danielpickett/ergogen-keyboard/docs/plates/right-switch-plate.dxf

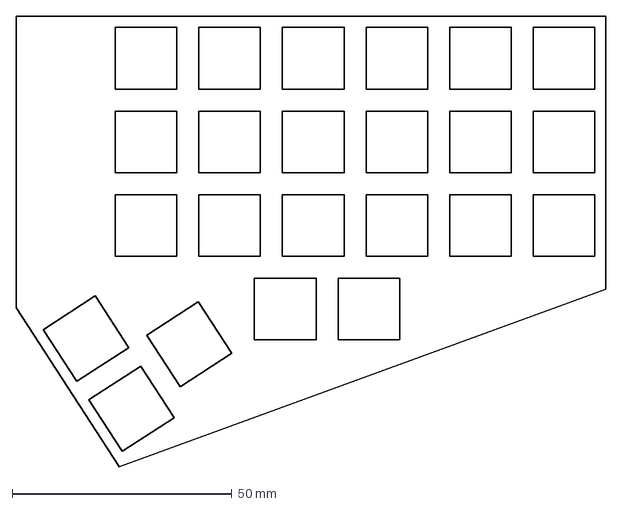
[picture p1: CAD file, 2026-11-01]
docs/plates/right-switch-plate.dxf
134.0 x 102.3 mm
