danielpickett/ergogen-keyboard/hardware/left.kicad_pcb

## KiCad design hardware/left.kicad_pcb (2026-11-01)

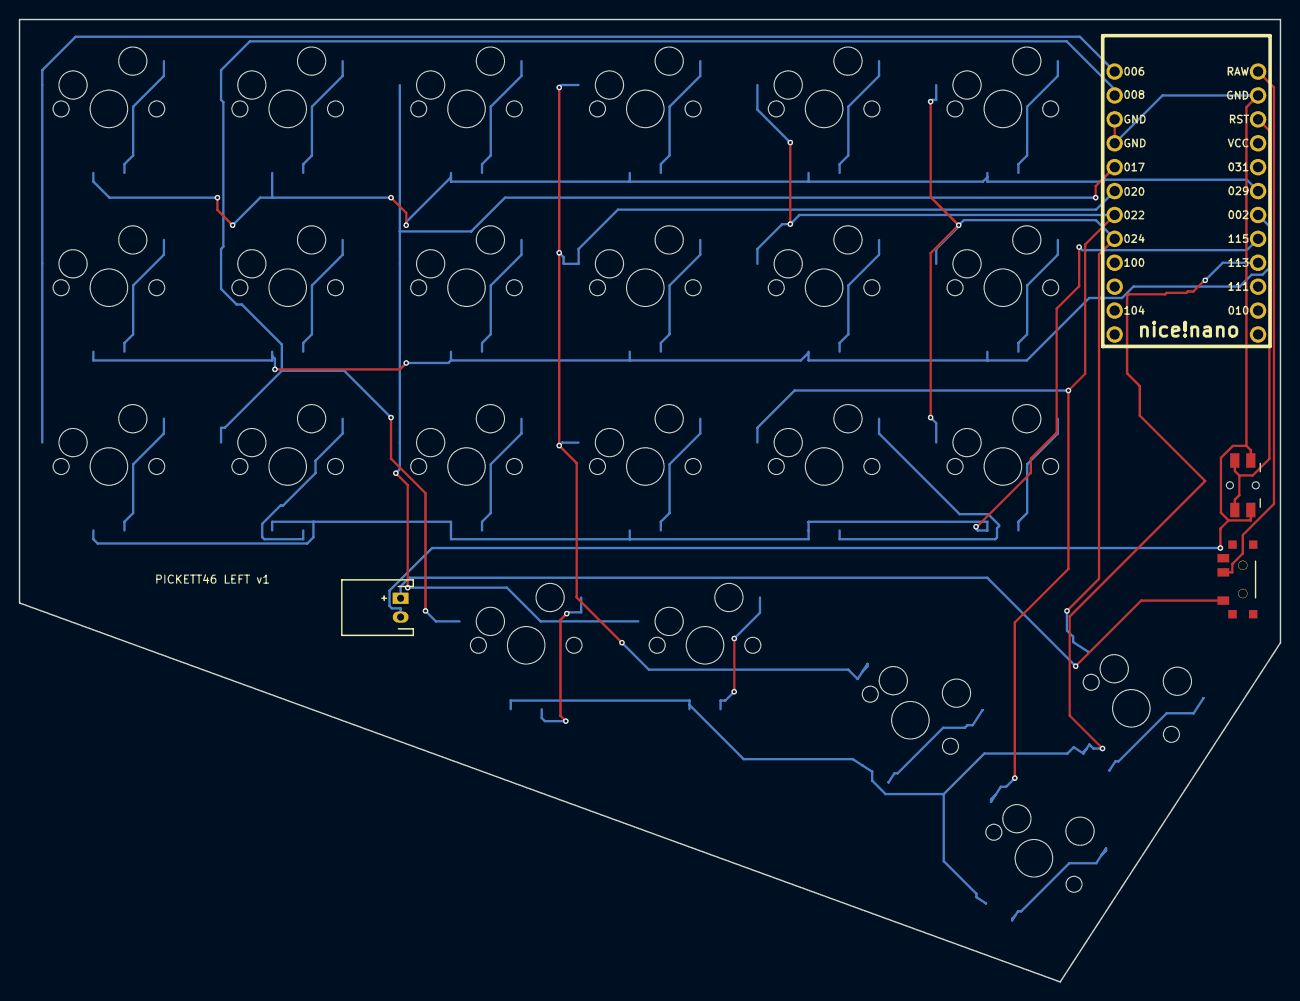
[picture p2: board left.kicad_pcb from above]

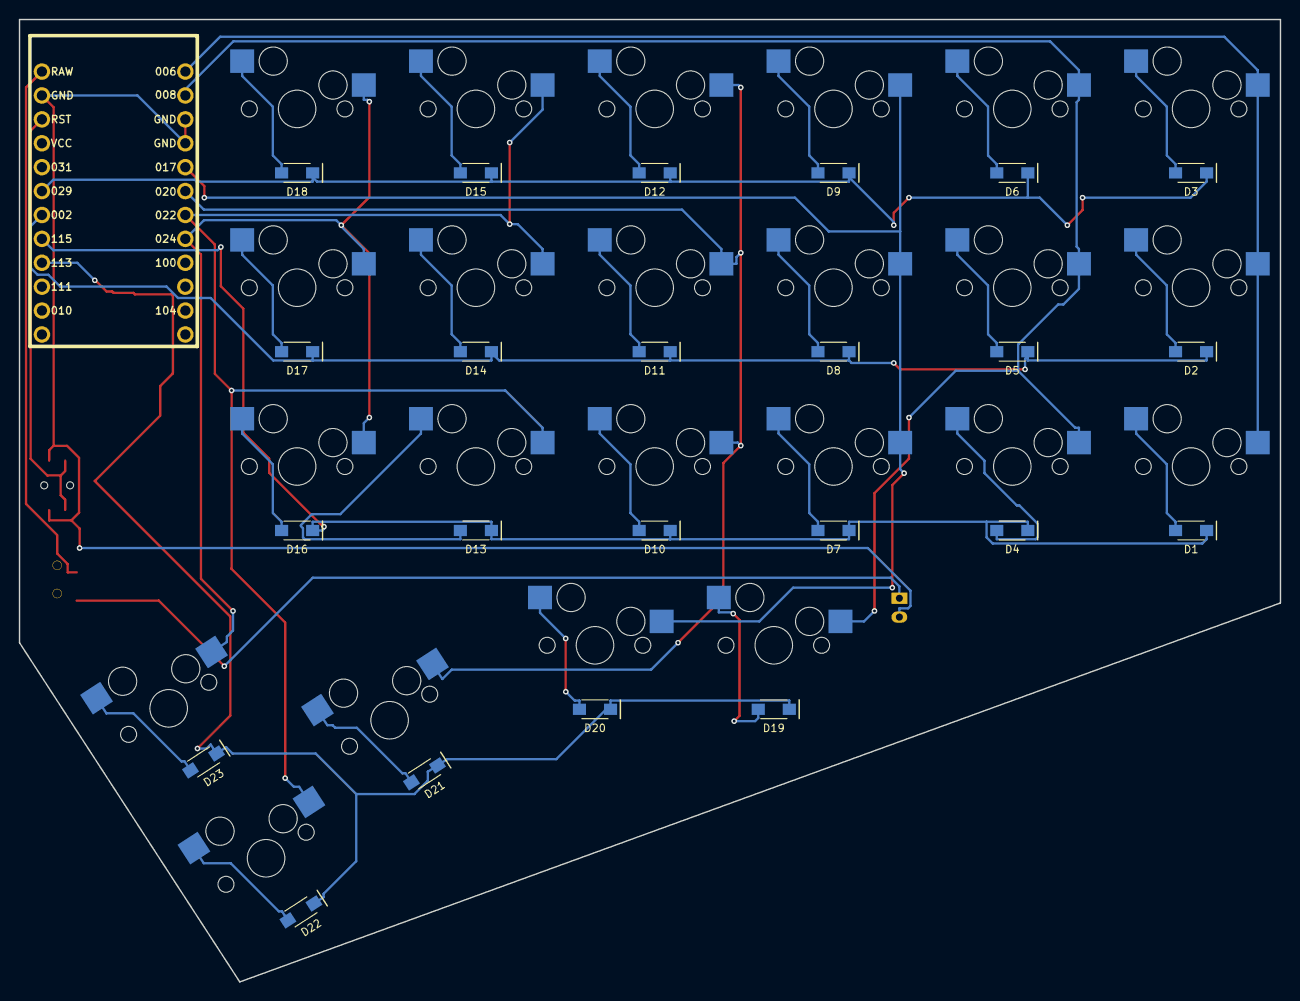
[picture p3: board left.kicad_pcb from below]

Board: 2 copper layers, 134.0 x 102.3 mm, 50 parts (23 on the bottom side), 37 nets.

Parts:
B1: Panasonic_EVQPUL_EVQPUC
D1, D2, D3, D4, D5, D6, D7, D8, D9, D10, D11, D12, D13, D14, D15, D16, D17, D18, D19, D20, D21, D22, D23: 1N4148W; D_SOD123
JST1: JST_PH_S2B-PH-K_02x2.00mm_Angled
MCU1: nice!nano v2, components up; nice_nano
S1, S2, S3, S4, S5, S6, S7, S8, S9, S10, S11, S12, S13, S14, S15, S16, S17, S18, S19, S20, S21, S22, S23: Kailh MX CPG151101S11; MX
T1: SPDT_C128955

Connections:
GND: B1.1, JST1.2, MCU1.3, MCU1.4, MCU1.23
P002: D2.1, D5.1, D8.1, D11.1, D14.1, D17.1, MCU1.18
P006: MCU1.1, S1.1, S2.1, S3.1
P008: MCU1.2, S4.1, S5.1, S6.1, S19.1
P017: MCU1.5, S7.1, S8.1, S9.1, S20.1
P020: MCU1.6, S10.1, S11.1, S12.1, S21.1
P022: MCU1.7, S13.1, S14.1, S15.1, S22.1
P024: MCU1.8, S16.1, S17.1, S18.1, S23.1
P029: D3.1, D6.1, D9.1, D12.1, D15.1, D18.1, MCU1.19
P113: D19.1, D20.1, D21.1, D22.1, D23.1, MCU1.16
P115: D1.1, D4.1, D7.1, D10.1, D13.1, D16.1, MCU1.17
RAW: MCU1.24, T1.2
RST: B1.2, MCU1.22
five_thumb: D23.2, S23.2
four_thumb: D22.2, S22.2
index_bottom: D13.2, S13.2
index_home: D14.2, S14.2
index_top: D15.2, S15.2
inner_bottom: D16.2, S16.2
inner_home: D17.2, S17.2
inner_top: D18.2, S18.2
middle_bottom: D10.2, S10.2
middle_home: D11.2, S11.2
middle_top: D12.2, S12.2
one_thumb: D19.2, S19.2
outer_bottom: D1.2, S1.2
outer_home: D2.2, S2.2
outer_top: D3.2, S3.2
pinky_bottom: D4.2, S4.2
pinky_home: D5.2, S5.2
pinky_top: D6.2, S6.2
pos: JST1.1, T1.1
ring_bottom: D7.2, S7.2
ring_home: D8.2, S8.2
ring_top: D9.2, S9.2
three_thumb: D21.2, S21.2
two_thumb: D20.2, S20.2
