danielpickett/ergogen-keyboard/(commit log)

2024-10-30 board outline not done, but was able to wire it up
2024-11-02 final nice_nano position; tighten up board outline
2024-11-02 remove reset switch
2024-11-02 tweak on/off switch and battery jack positions
2024-11-11 add right side PCB
2026-11-01 Complete routed wireless Pickett46 PCBs, fabrication packages and ZMK firmware
